prosper00/LMeter/20210511_144332.jpg

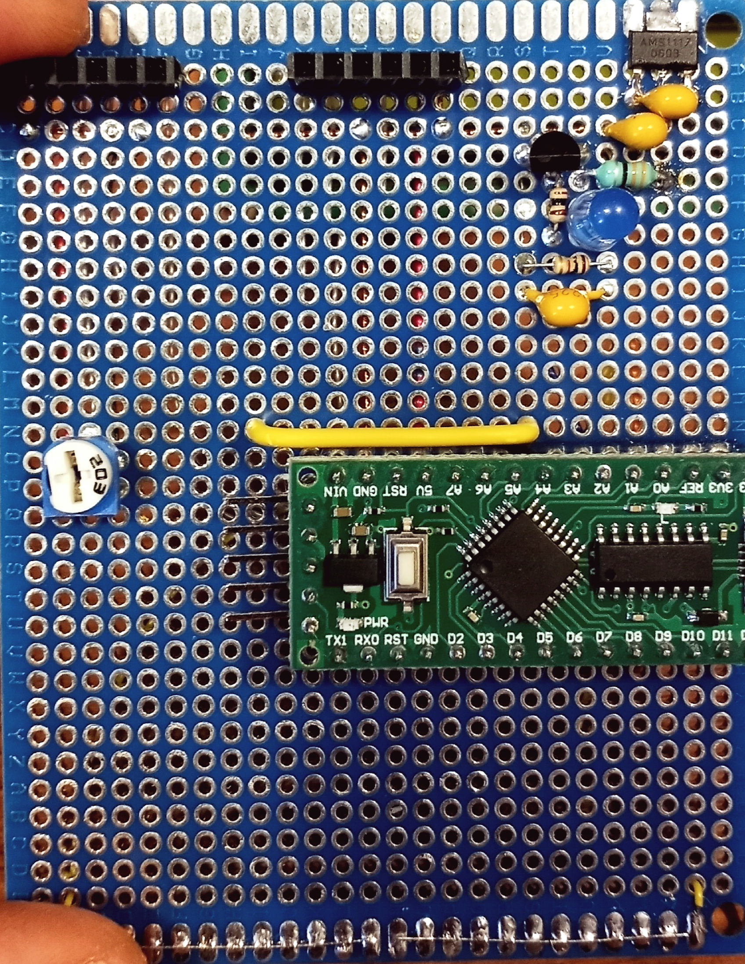
20210511_144332.jpg
