prosper00/LMeter/LMeter.pdf

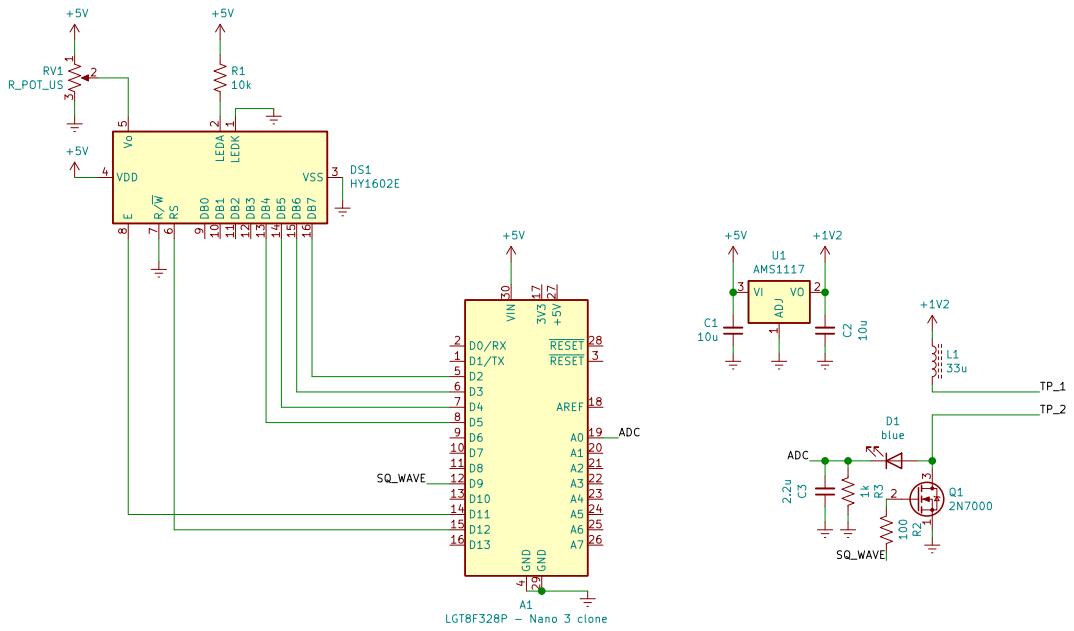
[picture p4: page 1]

Id: 1/1 Title: File: LMeter.sch Sheet: /
