prosper00/LMeter/LMeter.sch

## KiCad design LMeter.sch (2021-05-11)

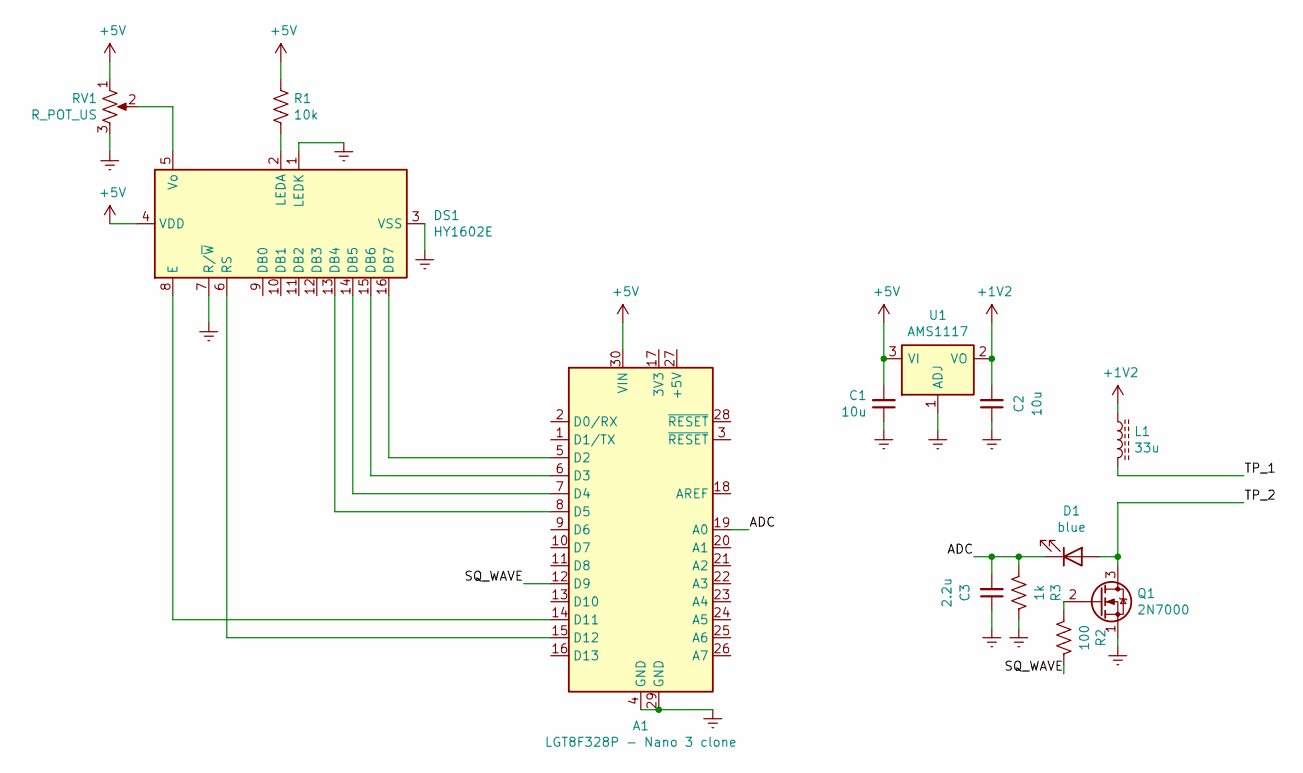
[picture p5: schematic LMeter.sch]

Parts:
A1: LGT8F328P - Nano 3 clone; Arduino_Nano
C1, C2: 10u
C3: 2.2u
D1: blue
DS1: HY1602E
L1: 33u
Q1: 2N7000; TO-92_Inline
R1: 10k
R2: 100
R3: 1k
RV1: R_POT_US
U1: AMS1117; SOT-223-3_TabPin2

Connections:
+1V2: C2.2, L1.1, U1.2 (VO)
+5V: A1.30 (VIN), C1.2, DS1.4 (VDD), R1.1, RV1.1, U1.3 (VI)
ADC: A1.19 (A0), C3.2, D1.1 (K), R3.1
Earth: A1.4 (GND), A1.29 (GND), C1.1, C2.1, C3.1, DS1.1 (LEDK), DS1.3 (VSS), DS1.7 (R/~W), Q1.1 (S), R3.2, RV1.3, U1.1 (ADJ)
unnamed: A1.5 (D2), DS1.16 (DB7)
unnamed: A1.6 (D3), DS1.15 (DB6)
unnamed: A1.7 (D4), DS1.14 (DB5)
unnamed: A1.8 (D5), DS1.13 (DB4)
unnamed: A1.14 (D11), DS1.8 (E)
unnamed: A1.15 (D12), DS1.6 (RS)
unnamed: DS1.2 (LEDA), R1.2
unnamed: DS1.5 (Vo), RV1.2
unnamed: Q1.2 (G), R2.1
SQ_WAVE: A1.12 (D9), R2.2
TP_1: L1.2
TP_2: D1.2 (A), Q1.3 (D)
