prosper00/LMeter/Calibration.xlsx

 | Inductor Value (+/-20%) | ADC reading (4V096 Ref)
 | 0 | #REF! | 3059 | 3060 | 3060
 | 0.27 | #REF! | 3048 | 3050 | 3050
 | 0.56 | #REF! | 3037 | 3039 | 3037
 | 1 | 0 | 3034 | 3036 | 3035 | 3031 | 3033 | 3030 |  |  |  | 784
 | 2.2 | #REF! | 2995 | 2985 | 2990
 | 2.7 | #REF! | 2996 | 2996 | 2996
 | 4.7 | #REF! | 2937 | 2924 | 2932
 | 5.6 | #REF! | 2915 | 2920 | 2922
 | 6.8 | #REF! | 2896 | 2887 | 2882
#REF! | 10 | #REF! | 2708 | 2786 | 2789 | 2825 | 2816 | 2821 | 2850 | 2852 | 2850
115.3181818 | 22 | 2537 | 2502 | 2522 | 2540 | 2586 | 2538 | 2534
#REF! | 33 | #REF! | 2409 | 2405 | 2411
#REF! | 47 | #REF! | 2175 | 2166 | 2157 | 2201 | 2219 | 2233
#REF! | 68 | #REF! | 1985 | 1961 | 1971 | 2007 | 2016 | 2013
#REF! | 100 | #REF! | 1766 | 1778 | 1786 | 1668 | 1673 | 1662
#REF! | 150 | #REF! | 1549 | 1536 | 1538
#REF! | 220 | #REF! | 1207 | 1212 | 1205 | 1237 | 1119 | 1216 | 1318 | 1315 | 1312
#REF! | 330 | #REF! | 1033 | 1052 | 1057 | 1008 | 946 | 952
4.302364066 | 470 | 2022.111111 | 794 | 744 | 794 | 759 | 766 | 773 | 763 | 770 | 767
#REF! | 560 | #REF! | 702 | 702 | 686
 | 1000 | #REF! | 531 | 508 | 517 | 509 | 514 | 505
 | 2200 | #REF! | 572
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
