prosper00/LMeter/(commit log)

2021-05-11 create project
    [LMeter.sch]
2021-05-11 add schematic pdf
2021-05-12 now with ADC-to-uH curve fitting
    [Calibration.xlsx]
2021-05-18 added curve for low value inductors. It's less accurate, but better than nothing.
    [Calibration.xlsx]
